MarvinHofmann/ESP-8266-IotButton/(list of files, drawings)

Other design files:
PCB/PCB_IoT_Button_2022-03-18.json
Schaltplan/SCH_IoTButton_2022-03-18.json
